dasta400/A3010-USBkbd/(commit log)

2019-01-17 Added Arduino code + Updated README
2022-06-19 Add photo of prototype
2022-06-19 Added picture of prototype
